JayesonLS/TandySticks/Joystick2.cpp

/*
  Joystick2.cpp

  Copyright (c) 2015, Matthew Heironimus
  Copyright (c) 2016, Titanium Studios Pty. Ltd.

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
  You should have received a copy of the GNU Lesser General Public
  License along with this library; if not, write to the Free Software
  Foundation, Inc., 51 Franklin St, Fifth Floor, Boston, MA  02110-1301  USA
*/

#include "Joystick2.h"

#if defined(_USING_HID)

#define JOYSTICK_REPORT_ID  0x03
#define JOYSTICK_STATE_SIZE 5

static const uint8_t _hidReportDescriptor[] PROGMEM = {
  
    0x05, 0x01,               // USAGE_PAGE (Generic Desktop)
    0x09, 0x04,               // USAGE (Joystick)
    0xa1, 0x01,               // COLLECTION (Application)
    0x85, JOYSTICK_REPORT_ID, // REPORT_ID (3)

    // 2 Buttons
    0x05, 0x09,               //   USAGE_PAGE (Button)
    0x19, 0x01,               //   USAGE_MINIMUM (Button 1)
    0x29, 0x02,               //   USAGE_MAXIMUM (Button 2)
    0x15, 0x00,               //   LOGICAL_MINIMUM (0)
    0x25, 0x01,               //   LOGICAL_MAXIMUM (1)
    0x75, 0x01,               //   REPORT_SIZE (1)
    0x95, 0x08,               //   REPORT_COUNT (8)
    0x55, 0x00,               //   UNIT_EXPONENT (0)
    0x65, 0x00,               //   UNIT (None)
    0x81, 0x02,               //   INPUT (Data,Var,Abs)

    // X and Y Axis
    0x05, 0x01,               //   USAGE_PAGE (Generic Desktop)
    0x09, 0x01,               //   USAGE (Pointer)
    0xA1, 0x00,               //   COLLECTION (Physical)
    0x16, 0x01, 0xFE,         //     LOGICAL_MINIMUM (-511)
    0x26, 0xFF, 0x01,         //     LOGICAL_MAXIMUM (511)
    0x75, 0x10,               //     REPORT_SIZE (16)
    0x95, 0x02,               //     REPORT_COUNT (2)
    0x09, 0x30,               //     USAGE (x)
    0x09, 0x31,               //     USAGE (y)
    0x81, 0x02,               //     INPUT (Data,Var,Abs)
    0xc0,                     //   END_COLLECTION
    0xc0,                     // END_COLLECTION
};

Joystick_::Joystick_()
{
    // Setup HID report structure
	  hid = new HID_();
	  HIDSubDescriptor *node = new HIDSubDescriptor(_hidReportDescriptor, sizeof(_hidReportDescriptor));
	  hid->AppendDescriptor(node);
    
    // Initalize State
    xAxis = 0;
    yAxis = 0;
    buttons = 0;
}

void Joystick_::begin(bool initAutoSendState)
{
    autoSendState = initAutoSendState;
    sendState();
}

void Joystick_::end()
{
}

void Joystick_::setButton(uint8_t button, uint8_t value)
{
    if (value == 0)
    {
        releaseButton(button);
    }
    else
    {
        pressButton(button);
    }
}
void Joystick_::pressButton(uint8_t button)
{
    bitSet(buttons, button);
    if (autoSendState) sendState();
}
void Joystick_::releaseButton(uint8_t button)
{
    bitClear(buttons, button);
    if (autoSendState) sendState();
}

void Joystick_::setXAxis(int16_t value)
{
    xAxis = value;
    if (autoSendState) sendState();
}
void Joystick_::setYAxis(int16_t value)
{
    yAxis = value;
    if (autoSendState) sendState();
}

void Joystick_::sendState()
{
    int8_t data[JOYSTICK_STATE_SIZE];

    data[0] = buttons;        
    data[1] = (int8_t)xAxis;
    data[2] = (int8_t)(xAxis >> 8);
    data[3] = (int8_t)yAxis;
    data[4] = (int8_t)(yAxis >> 8);

    // HID().SendReport(Report number, array of values in same order as HID descriptor, length)
    hid->SendReport(JOYSTICK_REPORT_ID, data, JOYSTICK_STATE_SIZE);
}

Joystick_ Joystick[2] =
{
    Joystick_(),
    Joystick_()
};

#endif // defined(_USING_HID)
