JayesonLS/TandySticks/(commit log)

2016-04-02 Initial commit of source files - adapter works but needs improvements to better handle noise.
    [Joystick2.cpp, Joystick2.h, TandyStick.cpp, TandyStick.h, TandySticks.ino]
2016-04-02 Properly times update loops, averages analog reads. Still needs button debounce, timeout for unplug and net sending repeat data.
2016-04-02 Change HID report descriptor to only have two buttons.
2016-04-03 Add button debounce.
2016-04-03 Adding schematic.
    [TandySticks.kicad_pcb, TandySticks.sch]
2016-04-03 Adding images of the prototype adapter.
2016-04-03 Subtract a small bias to the analog axis values. This is to simulate the minimum voltage that can be read through the Color Computer joystick port, and is to reduce issues reading min-level values di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
    [TandyStick.cpp, TandyStick.h, TandySticks.ino]
2016-04-23 Updating performance notes in the readme to be consistent with current hardware performance.
2016-04-23 Fix .gitignore so it doesn't ignore .lib files, commit missing kicad libraries.
2016-04-23 Updated license text so it was more clear that the circuit design is also public domain.
2016-05-29 Fixes to get working on Mac. Uses two hid devices with one joystick each, rather than one device with two joysticks.
    [Joystick2.cpp, Joystick2.h, TandySticks.ino]
2016-06-01 Add tolerance for the occasional < 1023 read when there is no joystick connected. On some occasions the adapter would occasionally incorrectly detect a joystick connected. This change fixes that.
    [TandyStick.cpp, TandyStick.h, TandySticks.ino]
